tsowell/avr-hdmi-cec-volume/schematic.sch

## KiCad design schematic.sch (2021-09-23)

Schematic: schematic.sch

Parts:
C1: 1uF
C2: 100nF
C3, C4: C_Small
J1: USB_B
J2: Motor
J3: HDMI pin 13
J4: UART
J5: ISP
U1: L293DNE; DIP-16_W7.62mm
U2: ATtiny4313-PU; DIP-20_W7.62mm
Y1: 16.384MHz
