tsowell/avr-hdmi-cec-volume/(threads)

Thread 1 (2021-09-22):

MISO/MOSI/SCK labels on the schematic with ATTINY4313 are wrong

SzymonSlupik, 2021-09-22:
It seems the MISO/MOSI/SCK labels are on wrong pins. SCK should be 19.

tsowell, 2021-09-23:
You're right, SCK and MISO were swapped.  Sorry about that!  2a198c1 fixes this in the schematic and svg.  Thank you for pointing this out!

Closed 2021-09-23.

Thread 2 (2021-09-24):

Debug hints?

SzymonSlupik, 2021-09-24:
Hi Thomas,
I have prepared a test board following your sch (thanks for fixing the pin labels!). In principle it works, but the final results show some potential issues with my setup. Do you have any hints where to look for / what to try?

I have a Philips TV with 3 devices connected:
- Apple TV
- Raspberry Pi (running CEC Client)
- Your ATTINY board

The CEC Client scan produces this output:
```
pi@redpi:~ $ echo "scan" | cec-client RPI -s -d 1
opening a connection to the CEC adapter...
requesting CEC bus information ...
ERROR:   [           10612]     failed to request the physical address
CEC bus information
===================
device #1: Recorder 1
address:       2.0.0.0
active source: no
vendor:        Pulse Eight
osd string:    CECTester
CEC version:   1.4
power status:  on
language:      eng

device #4: Playback 1
address:       3.0.0.0
active source: no
vendor:        Apple
osd string:    Bedroom
CEC version:   2.0
power status:  on
language:      ???

device #5: Audio
address:       f.f.f.f
active source: no
vendor:        Unknown
osd string:    Audio
CEC version:   unknown
power status:  unknown
language:      ???

currently active source: unknown (-1)
```

At the same time the debug output shows this:

```
<int>
<int>
e0
e0
e0
min
error -1
min
error -1
e0
<int>
e0
11
min
error -1
min
error -1
11
11
min
error -1
ee
min
error -1
1f:84:20:00:01
10
10
10
10
<int>
10
10
min
error -1
10
10
10
min
error -1
12
12
13
13
13
14
15
min
error -1
16
16
17
min
error -1
17
<int>
min
error -1
18
min
error -1
19
19
1a
min
error -1
1a
1b
1b
1b
1c
1c
1c
min
error -1
<int>
min
error -1
1d
1e
1e
1e
1f:85
<int>
min
error -1
<int>
14:8c
min
error -1
14:83
4f:84:30:00:04
14:9f
min
error -1
14:8f
<int>
min
error -1
41:47:42:65:64:72:6f:6f:6d
14:91
max
error -1
min
error -1
15:8c
<vendor id>
<int>
15:8c
<vendor id>
<int>
15:8c
<vendor id>
<int>
min
error -1
max
error -1
min
error -1
<int>
15:83
<phys address>
<int>
min
error -1
min
error -1
min
error -1
min
error -1
15:8f
<power status>
<int>
min
error -1
15:46
<osd name>
<int>
min
error -1
15:91
<int>
15:91
<int>
1f:85
<int>
min
error -1
<int>
```

Any hints where to start / what to look for are appreciated!

SzymonSlupik, 2021-09-25:
OK it seems I am getting some progress now - the issue was I was using wrong GND. Now the signal seems quite stable and the CEC decoding works - the debug output looks like this:
```
1e
1e
1e
1f:85
<int>
1f:85
<int>
14:8c
4f:87:00:10:fa
14:83
4f:84:30:00:04
14:9f
41:9e:06
14:8f
41:90:00
<int>
14:46
41:47:42:65:64:72:6f:6f:6d
14:91
41:00:91:00
15:8c
<vendor id>
15:83
<phys address>
<int>
15:83
<phys address>
<int>
15:9f
<int>
15:9f
<int>
15:8f
<power status>
<int>
15:46
<osd name>
15:91
<int>
15:91
<int>
1f:85
<int>
1f:85
<int>

```
Raspberry PI cec-client is still reporting some issues - like the f.f.f.f address.
```
pi@redpi:~ $ echo "scan" | cec-client RPI -s -d 1
opening a connection to the CEC adapter...
requesting CEC bus information ...
ERROR:   [            9393]     failed to request the physical address
CEC bus information
===================
device #1: Recorder 1
address:       2.0.0.0
active source: no
vendor:        Pulse Eight
osd string:    CECTester
CEC version:   1.4
power status:  on
language:      eng

device #4: Playback 1
address:       3.0.0.0
active source: no
vendor:        Apple
osd string:    Bedroom
CEC version:   2.0
power status:  on
language:      ???

device #5: Audio
address:       f.f.f.f
active source: no
vendor:        Unknown
osd string:    PioneerSX-950
CEC version:   unknown
power status:  on
language:      ???

currently active source: unknown (-1)
pi@redpi:~ $
```
I need to dive deeper into the CEC protocol to figure out what is going on. Still any hints would be appreciated.

tsowell, 2021-09-25:
Hi Szymon,

I'm glad to hear that you're making progress!  I don't know if I will be much help, but I do have a couple of suggestions:

1. Try disabling debug output.  I don't know how quickly the Pi expects responses, but it does take a long time to write out to the UART.  The debug output might introduce enough delay to affect CEC command timing.

2. Try connecting the Pi directly to the ATTINY board to see if it works better with no other devices on the CEC bus.

I will try to get my device connected to a Pi this weekend so I can share the expected cec-client output, but let me know if you make any more progress in the meantime.  Good luck!

SzymonSlupik, 2021-09-27:
I got rid of the [ERROR: [9393] failed to request the physical address] - the response was using a wrong opcode (0x87 vs 0x84). Reported this as #3
Still don't understand why it reports "address: f.f.f.f". Parameters mismatch in the response message?
```
pi@redpi:~ $ echo "scan" | cec-client RPI -s -d 1
opening a connection to the CEC adapter...
requesting CEC bus information ...
CEC bus information
===================
device #1: Recorder 1
address:       1.0.0.0
active source: no
vendor:        Pulse Eight
osd string:    CECTester
CEC version:   1.4
power status:  on
language:      eng

device #5: Audio
address:       f.f.f.f
active source: no
vendor:        Unknown
osd string:    PioneerSX-950
CEC version:   unknown
power status:  on
language:      ???

currently active source: unknown (-1)
pi@redpi:~ $
```

SzymonSlupik, 2021-12-30:
It seems I am now done with my HDMI CEC projects for some time. Thanks for setting a great foundation, Thomas. Based on your work I have created two new projects:
- [CEC-Tiny-Pro](https://github.com/SzymonSlupik/CEC-Tiny-Pro), serving mostly as a playground / sniffer / debugger
- [CEC-Tiny](https://github.com/SzymonSlupik/CEC-Tiny) - an ATTINY25-based implementation of device on/off

Hope you are OK with how I have attributed your work. If you have any suggestions WRT the copyright and other attributions - please let me know, otherwise please close this issue, as I believe the "debugging" part has now been addressed.

tsowell, 2022-01-23:
Hi Szymon, that's a beautiful vintage TV.  It's cool that you found a way to give it new life.  Thanks for the attribution in your projects!  I'm so glad you found my work useful.

Sorry for not getting back to you sooner, but I'll close this issue now.

Closed 2022-01-23.

Thread 3 (2021-09-27):

report_physical_address should be 0x84

SzymonSlupik, 2021-09-27:
report_physical_address uses opcode 0x87 (Device Vendor ID). I think it should be using 0x84.

tsowell, 2021-09-28:
You're right, sorry about that.  It looks like I copied report_physical_address from device_vendor_id and never updated the contents.  My TV doesn't seem to mind, but I'm not surprised that other devices have problems with it.  684e8c1 is an attempt to correctly support for the Report Physical Address, but I haven't tested it yet.

tsowell, 2021-09-29:
Looks like 684e8c1 fixes this.  I'm going to leave the issue open I've tested it on my setup and merged it.

SzymonSlupik, 2021-12-30:
The fix is OK - thanks!

Closed 2021-12-30.

Thread 4 (2021-09-27):

System Audio Mode Request should be 0x7d

SzymonSlupik, 2021-09-27:
```
case 0x70:
#ifdef DEBUG
					/* System Audio Mode Request */
					printf_P(PSTR("<sys audio>\n"));
#endif /* DEBUG */
					_delay_ms(13);
					set_system_audio_mode(ADDRESS, 0x0f, 1);
					break;
```

should (most likely) be
```
case 0x7d:
#ifdef DEBUG
					/* System Audio Mode Request */
					printf_P(PSTR("<sys audio>\n"));
#endif /* DEBUG */
					_delay_ms(13);
					set_system_audio_mode(ADDRESS, 0x0f, 1);
					break;
```

tsowell, 2021-09-29:
Thanks for testing this and responding in the commit.  I'll see if my TV is happy with 0x72 in response to 0x7d, but I may #ifdef this anyway because it seems to differ from the spec.  I'll leave the issue open until then.

SzymonSlupik, 2021-09-29:
So according to this (for example): [http://www.andrewncarr.com/hdmi/hdmi-cec-codes.xls](http://www.andrewncarr.com/hdmi/hdmi-cec-codes.xls),
```
If device does not <Feature Abort> the following message:
   <Give System Audio Status>
 It shall be able to send the message(s):
   <Set System Audio Mode>, <System Audio Mode Status>
```

So perhaps Apple's implementation is in line with the spec?

SzymonSlupik, 2021-10-01:
I have also tested this with a Philips TV

After this exchange:
```
-> 05:7d audio mode?
<- 5f:7e audio status
```
the TV does not send any volume requests over the CEC bus.

But after this (responding with 72 to 7d):
```
-> 05:7d audio mode?
<- 5f:72 set audio
```

The TV remote V+/V- button presses are relayed to the CEC bus.

So the Philips implementation behaves identically to the Apple implementation.

SzymonSlupik, 2021-12-30:
You are right, Thomas.

0x70 <System Audio Mode Request> is responded by 0x72 <Set System Audio Mode>
0x7d <Give System Audio Mode Status> is responded by 0x7e <System Audio Mode Status>

I'm closing the issue - thanks for clarifying.

Closed 2021-12-30.

Thread 5 (2021-09-28):

<max> error returned repeatedly

SzymonSlupik, 2021-09-28:
When I have the ATTINY connected to the CEC output of an Apple TV, on top of properly reported messages it reports a sequence (typically 3 in a row) of <max> errors.

This happens upon powering up (I have modified the debug printout a bit, but I think it is clear what the code reports):
```
Rx-> 45:7d audio status?
<-Tx 5f:72 set audio
Rx-> 4f:90:00 pwr
max E -1
max E -1
max E -1
```
and upon powering down (sleep mode):
```
Rx-> 4f:36 all sby
max E -1
max E -1
max E -1
```
The captured waveform of a single "max error" frame looks like this:

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

Any ideas what is going on and how to fix this?

tsowell, 2021-09-29:
This looks to me like an aborted frame: start bit, initiator=0b0100, destination=0b0000, EOM=0 (not end-of-message), ACK=1 (not acknowledged), then free time followed by a new frame.  My best guess is that the initiator is retransmitting the frame after the header block was not acknowledged (probably because there is no device on the bus with address 0).  It's not clear to me from the spec whether or not an initiator should retransmit a frame before it finishes sending it the first time, but I think the behavior on the ATTINY end is correct regardless: move on and start reading the next frame.  Do you see any issues with that?

SzymonSlupik, 2021-09-29:
OK I think I have it. Below several sequences are captured.

```
[Apple TV startup]
Rx-> 45:7d audio status?
<-Tx 5f:72 set audio
Rx-> 4f:90:00 pwr
max E -1
max E -1
max E -1
max E -1
max E -1

[Volume up/down pressed on the Apple remote]
Rx-> 45:44:41 v up
Rx-> 45:45 rel
Rx-> 45:44:42 v dn
Rx-> 45:45 rel

[Apple TV shutdown - the STANDBY message received properly]
Rx-> 4f:36 all sby
max E -1
max E -1
max E -1
max E -1

[Apple TV startup]
Rx-> 45:7d audio status?
<-Tx 5f:72 set audio
Rx-> 4f:90:00 pwr
max E -1
max E -1
max E -1
max E -1
max E -1

[Apple TV shutdown - no STANDBY message received]
max E -1
max E -1
max E -1

[Apple TV startup]
Rx-> 45:7d audio status?
<-Tx 5f:72 set audio
Rx-> 4f:90:00 pwr
max E -1
max E -1
max E -1
max E -1
max E -1

[Apple TV shutdown - no STANDBY message received]
max E -1
max E -1
max E -1

[Apple TV startup]
Rx-> 45:7d audio status?
<-Tx 5f:72 set audio
Rx-> 4f:90:00 pwr
max E -1
max E -1
max E -1
max E -1

[Volume up/down pressed on the Apple remote]
Rx-> 45:44:41 v up
Rx-> 45:45 rel
Rx-> 45:44:42 v dn
Rx-> 45:45 rel

[Apple TV shutdown - the STANDBY message received properly]
Rx-> 4f:36 all sby
max E -1
max E -1
max E -1

[Apple TV startup]
Rx-> 45:7d audio status?
<-Tx 5f:72 set audio
Rx-> 4f:90:00 pwr
max E -1
max E -1
max E -1
max E -1
max E -1

[Other CEC traffic injected from another device (Raspberry Pi)]
Rx-> 1f:84:30:00:01 addr map
Rx-> 1f:85 sys discovery
Rx-> 4f:82:10:00 otp
Rx-> 14:8c vid?
Rx-> 4f:87:00:10:fa vid
Rx-> 14:9f CEC v?
Rx-> 41:9e:06 CEC v
Rx-> 14:46 osd?
Rx-> 41:47:42:65:64:72:6f:6f:6d osd
Rx-> 14:91 lang?
Rx-> 41:00:91:00 ???
Rx-> 15:8c vid?
<-Tx 5f:87 vid
Rx-> 15:83 phys addr?
<-Tx 5f:84 phys addr
Rx-> 15:9f CEC v?
Rx-> 15:9f CEC v?
Rx-> 15:8f pwr?
<-Tx 51:90 rep pwr
Rx-> 15:46 osd?
<-Tx 51:47 osd
Rx-> 15:91 lang?
Rx-> 15:91 lang?
Rx-> 18:8c vid?
Rx-> 8f:87:00:1a:11 ???
Rx-> 18:83 phys addr?
Rx-> 8f:84:50:00:04 addr map
Rx-> 18:9f CEC v?
Rx-> 81:9e:05 CEC v
Rx-> 18:8f pwr?
Rx-> 81:90:00 pwr
Rx-> 18:46 osd?
Rx-> 81:47:43:68:72:6f:6d:65:63:61:73:74 osd
Rx-> 18:91 lang?
Rx-> 81:00:91:04 abort

[Apple TV shutdown - the STANDBY message received properly]
Rx-> 4f:36 all sby
max E -1
max E -1

```

What you can see:

1. If the AppleTV is shut down immediately after the startup (no CEC messages in between), the standby message is not received.
2. If there is any CEC traffic in-between the startup and the shutdown, the standby message is received properly. This "in-between" traffic can be anything - either generated by the AppleTV or another device.

My hypothesis is the ATTINY code does not recover properly from an aborted message and as a result the next message after the aborted one (the all standby in my case) is dropped (I believe AppleTV is still sending it properly). I do not fully follow what happens in the code after the <max> error, but it seems it may cause the next message after that to be dropped.

SzymonSlupik, 2021-12-30:
I no longer have these issues. It might have been a hardware issue (no calibrated oscillator?). I have gone through multiple HW revisions on my end and have not seen these errors for a long time now. I think this can be closed.

Closed 2021-12-30.
