tsowell/avr-hdmi-cec-volume/(commit log)

2021-09-23 Fix swapped SCK/MISO pins
    [schematic.sch]
2021-09-28 Fix Report Physical Address message
    As reported in issue #3, the Report Physical Address message was
    implemented incorrectly. It looks like I had copied and pasted it from
    the Device Vendor ID message and never updated it.
    [main.c]
